Brandon-Valley/Artemis-Corner-DAQ-Board/Artemis Corner Board V2 FR.brd

## EAGLE design Artemis Corner Board V2 FR.brd (2016-04-18)

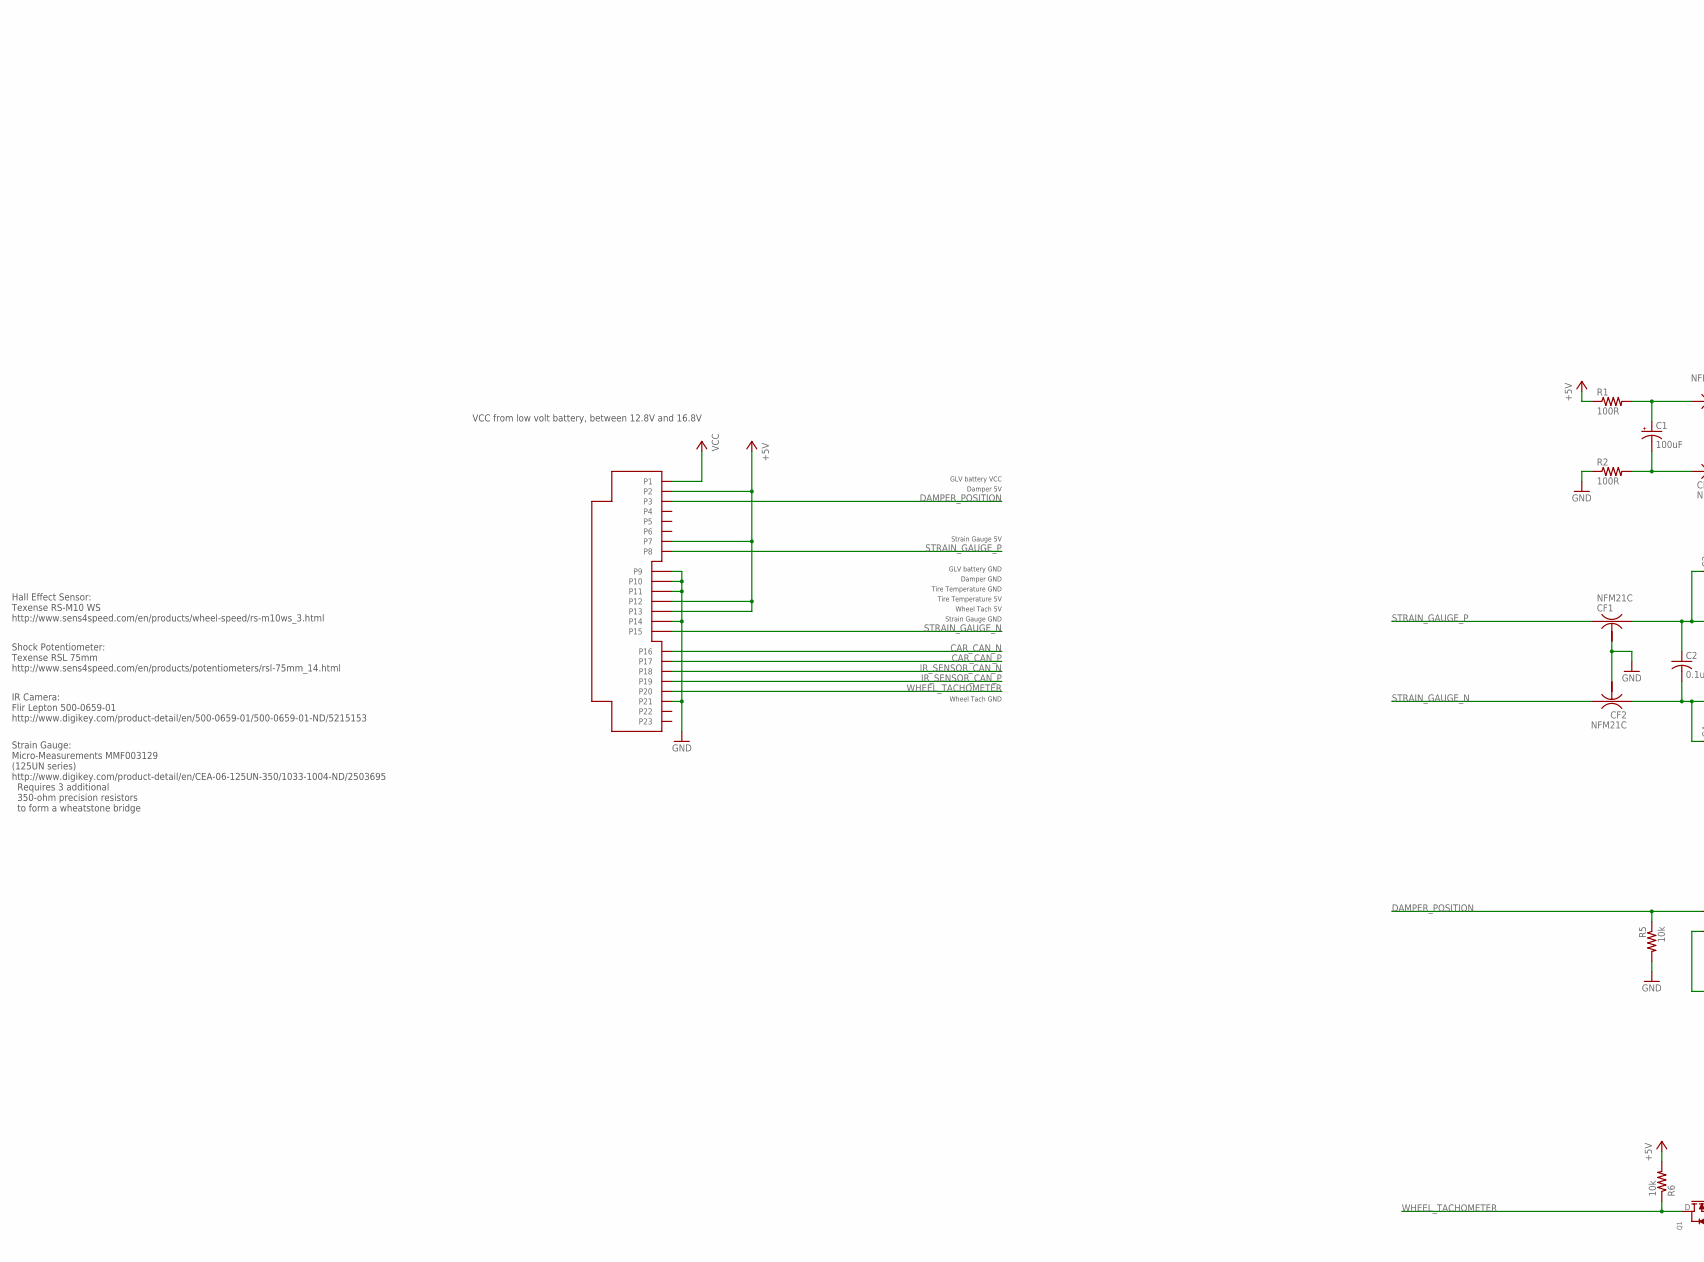
[picture p1: schematic Artemis Corner Board V2 FR.sch, part in row 1, column 1]

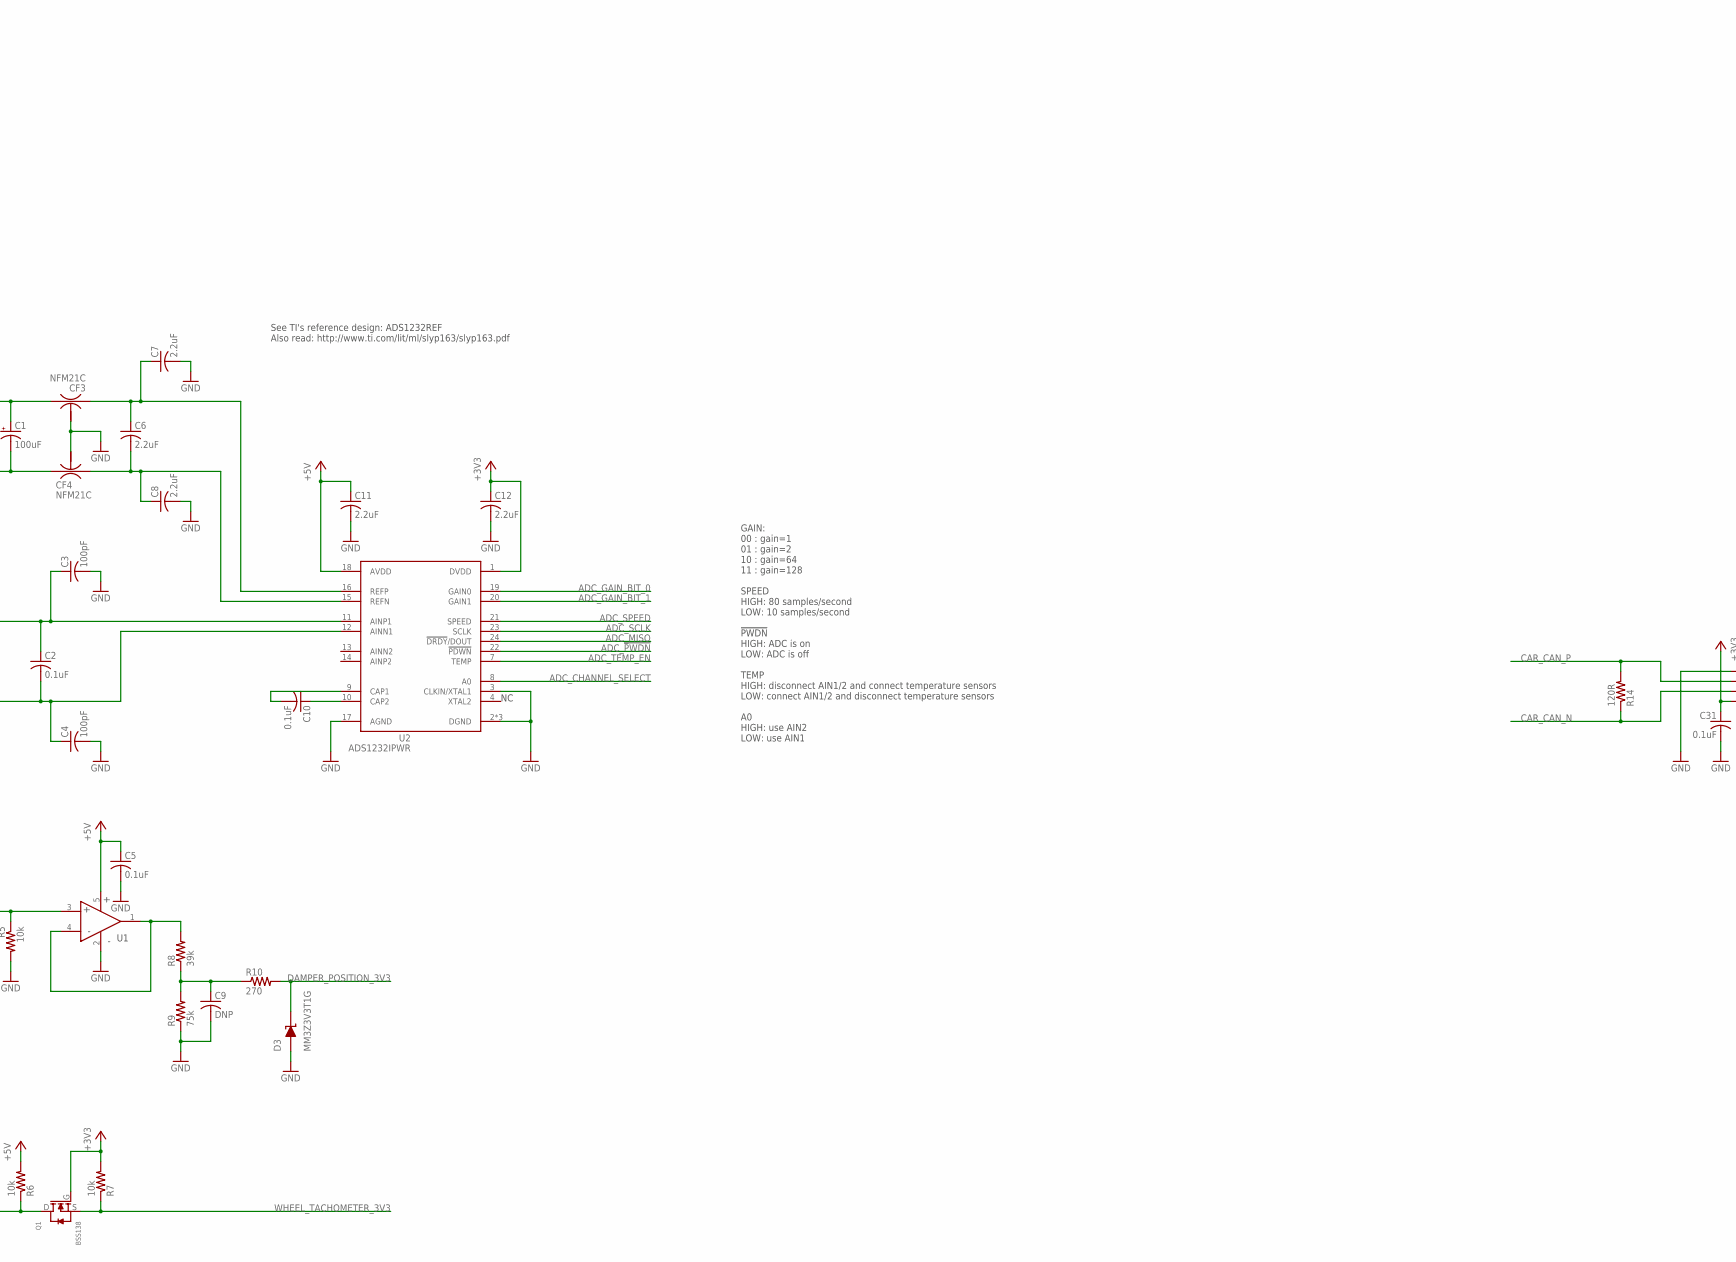
[picture p2: schematic Artemis Corner Board V2 FR.sch, part in row 1, column 2]

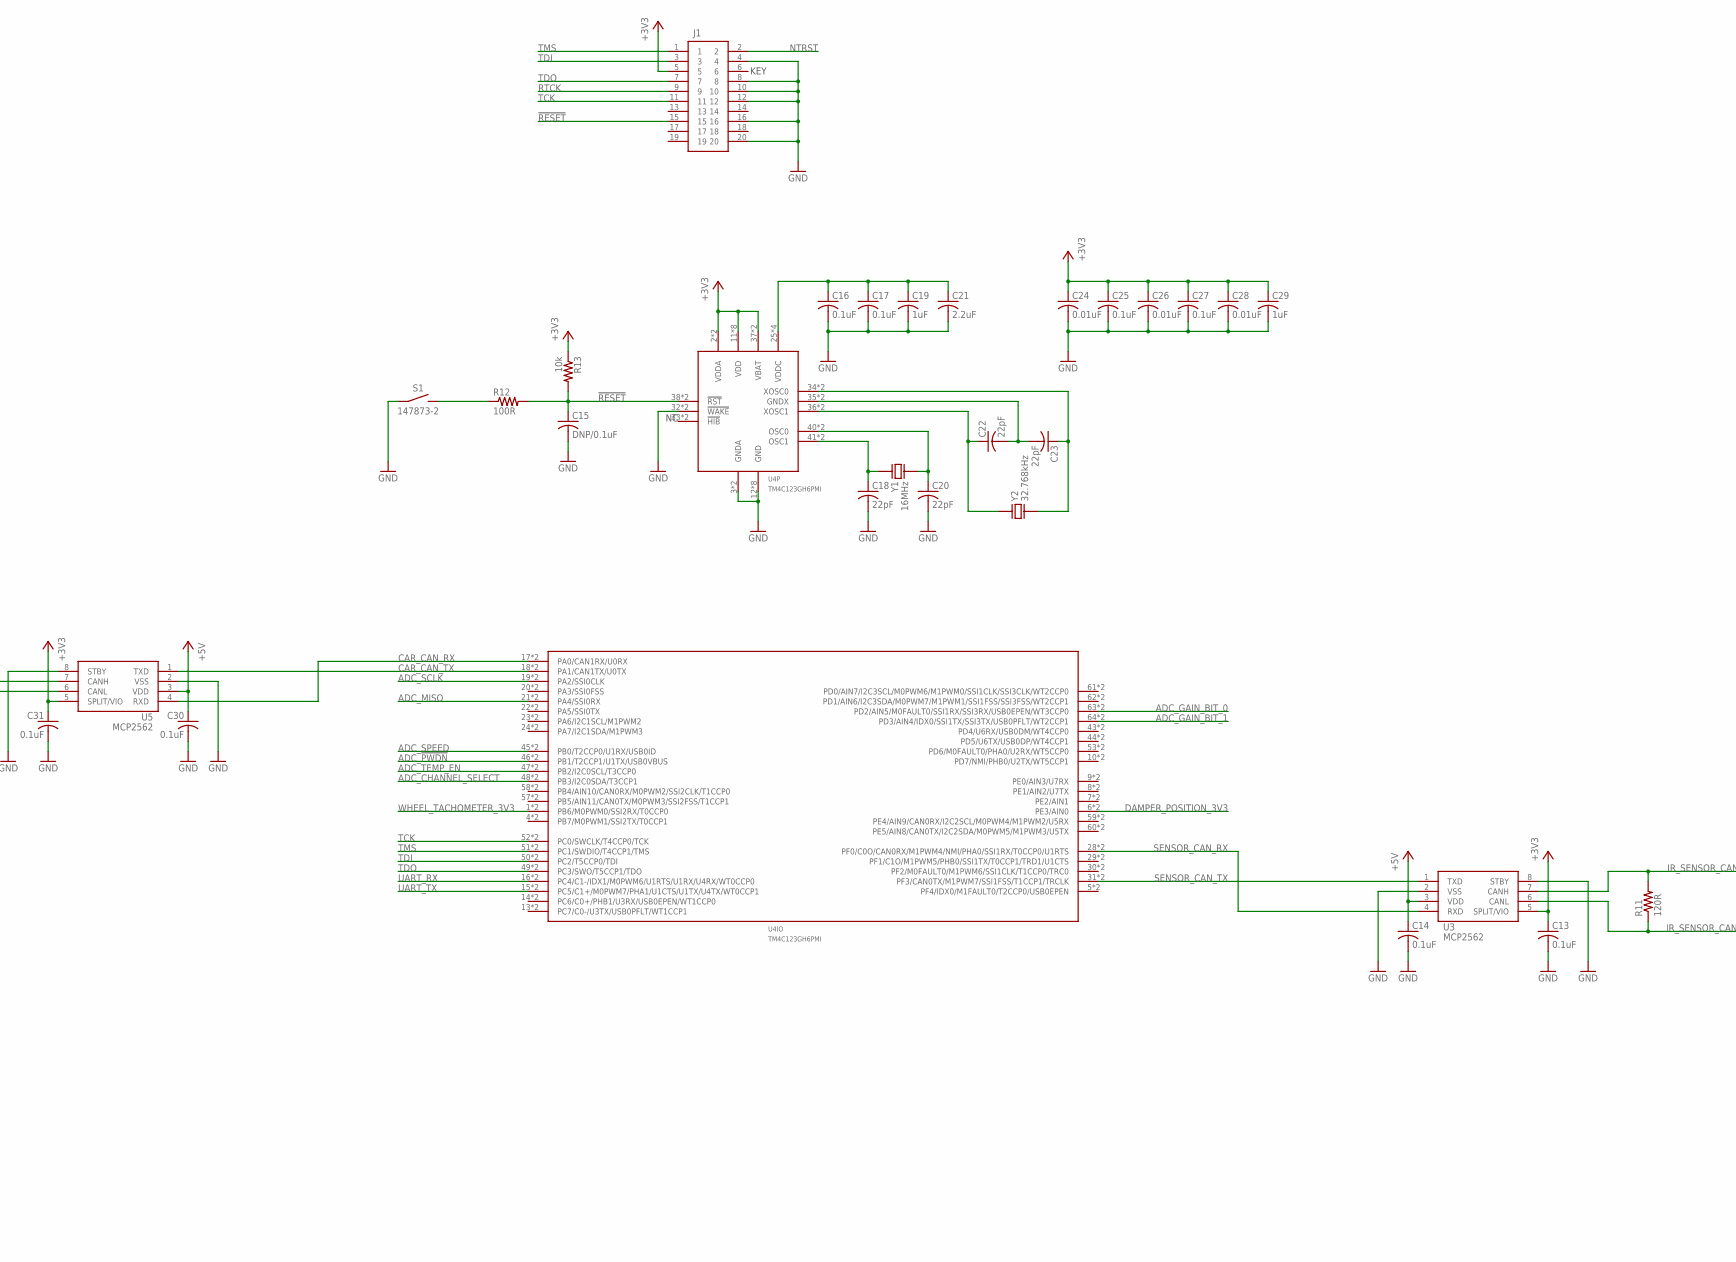
[picture p3: schematic Artemis Corner Board V2 FR.sch, part in row 1, column 3]

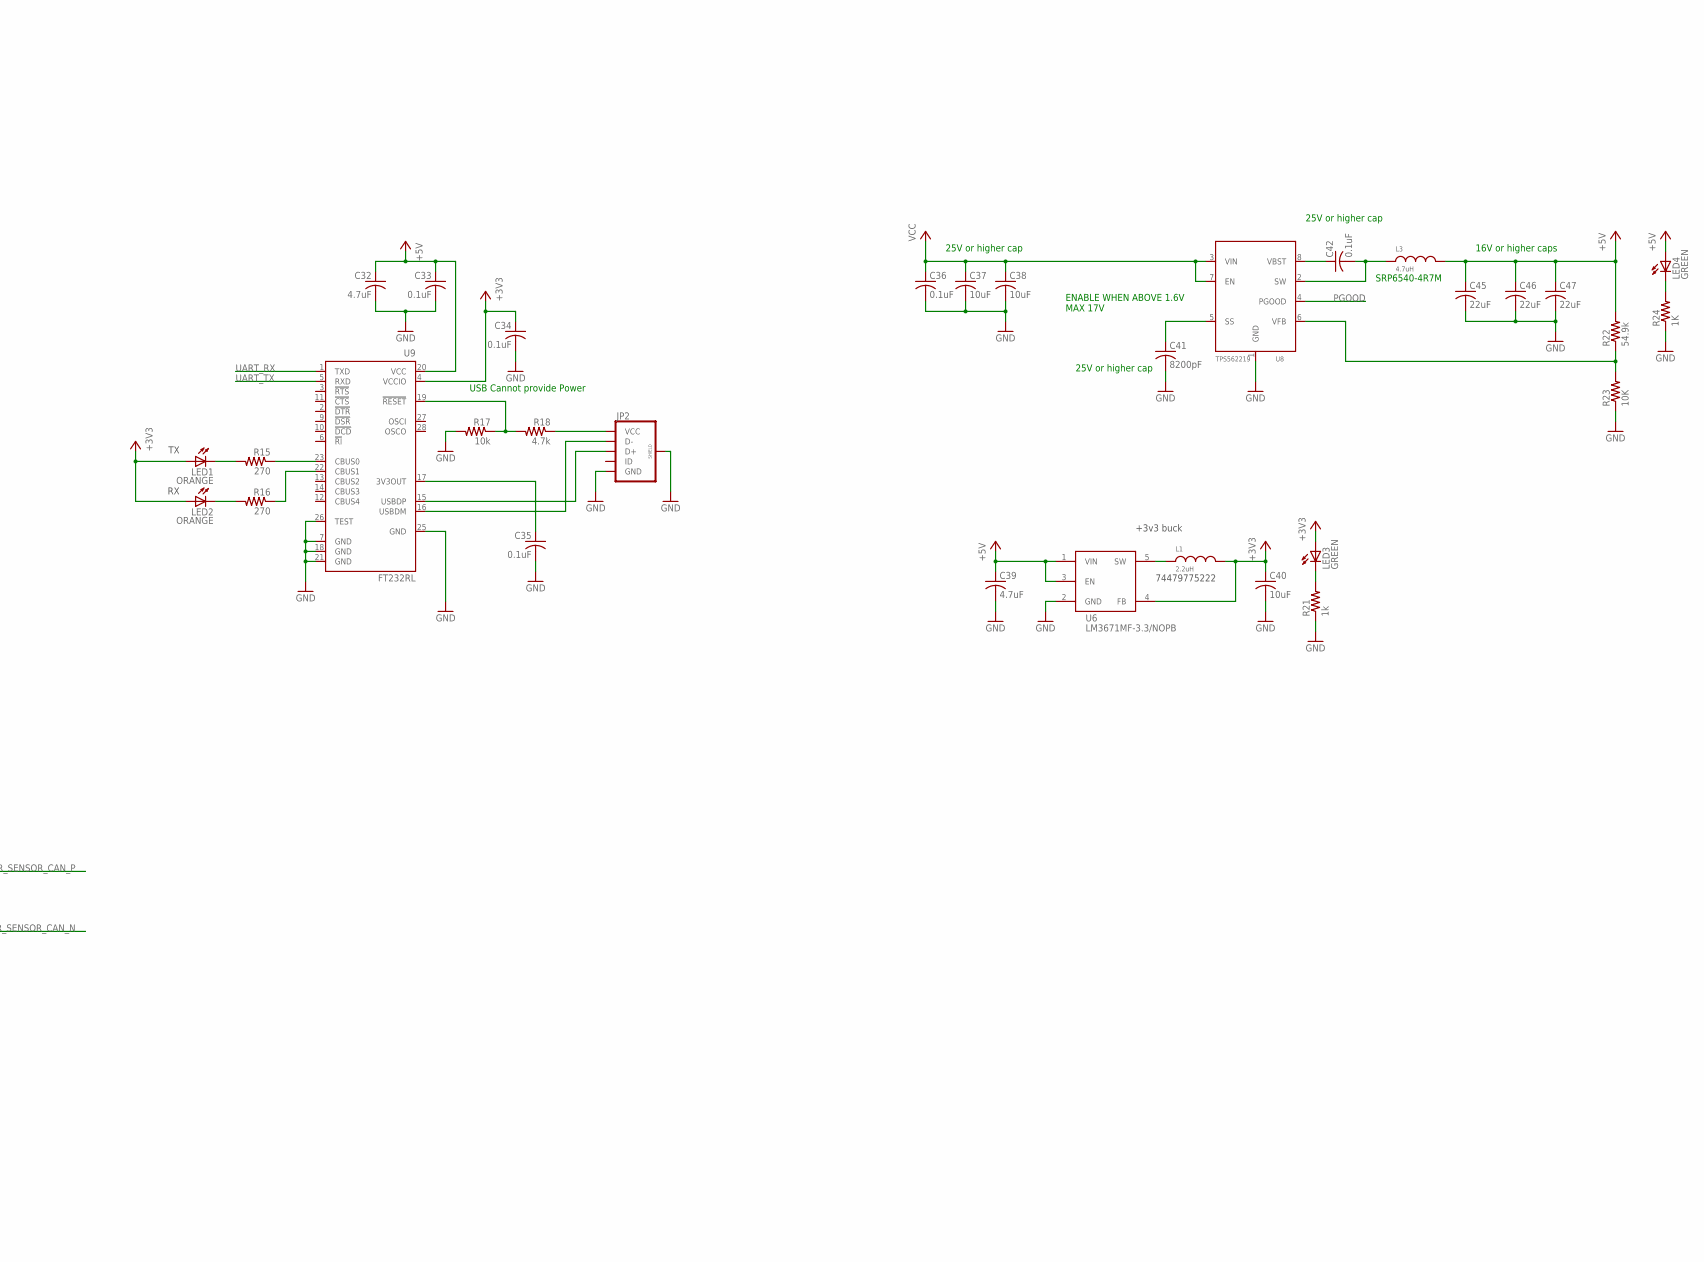
[picture p4: schematic Artemis Corner Board V2 FR.sch, part in row 1, column 4]

Parts:
C1: 100uF; D/7343-31W; PARTNO T494D107K010AT
C2, C10: 0.1uF; C0805; PARTNO *
C3, C4: 100pF; C0805; PARTNO *
C5, C13, C14, C16, C17, C25, C27, C30, C31, C33, C34, C35, C36, C42: 0.1uF; C0805; PARTNO GRM21BR71E104KA01L
C6, C7, C8, C11, C12, C21: 2.2uF; C0805; PARTNO *
C9: DNP; C0805; PARTNO *
C15: DNP/0.1uF; C0805; PARTNO *
C18, C20, C22, C23: 22pF; C0805; PARTNO C0805C220K5GACTU
C19, C29: 1uF; C0805; PARTNO *
C24, C26, C28: 0.01uF; C0805; PARTNO *
C32: 4.7uF; C0805; PARTNO GRM21BR71A475KA73K
C37, C38: 10uF; C0805; PARTNO GRM21BR61E106KA73L
C39: 4.7uF; C0805
C40: 10uF; C0805
C41: 8200pF; C0805; PARTNO C0805C822K5RACTU
C45, C46, C47: 22uF; C0805; PARTNO C2012JB1E226M125AC
CF1, CF2, CF3, CF4: NFM21C; PARTNO NFM21PC105B1C3D
D3: MM3Z3V3T1G; SOD-323; PARTNO MM3Z3V3T1G
H1: 776228-4
J1: CTI-20-MALE; SAMTEC-FTR-DUALROW; PARTNO M50-3601042
JP2: USB_MICROB_PLUG-PTH3; MOLEX-MICROUSB-B-105017-0001; PARTNO 1050170001
L1: 2.2uH; 0805; PARTNO 74479775222
L3: 4.7uH; SRP6540; PARTNO SRP6540-4R7M
LED1, LED2: ORANGE; CHIP-LED0805; PARTNO 598-8130-107F
LED3, LED4: GREEN; CHIP-LED0805; PARTNO 598-8170-107F
Q1: BSS138
R1, R2: 100R; R0805
R5, R6, R7, R17: 10k; R0805; PARTNO ERJ-6ENF1002V
R8: 39k; R0805; PARTNO ERJ-6ENF3902V
R9: 75k; R0805; PARTNO ERJ-6ENF7502V
R10, R15, R16: 270; R0805; PARTNO ERJ-6ENF2700V
R11, R14: 120R; R0805; PARTNO ERJ-6ENF1200V
R12: 100R; R0805; PARTNO *
R13: 10k; R0805; PARTNO *
R18: 4.7k; R0805; PARTNO ERJ-6ENF4701V
R21: 1k; R0805; PARTNO ERJ-6ENF1001V
R22: 54.9k; R0805; PARTNO ERA-6AEB5492V
R23: 10K; R0805; PARTNO ERJ-6ENF1002V
R24: 1K; R0805; PARTNO ERJ-6ENF1001V
S1: 147873-2; TE-147873-2; PARTNO 147873-2
U1: OPA365AIDBVR; SOT23-5
U2: ADS1232IPWR; ADS1232IPW
U3, U5: MCP2562; SOIC8-N_MC; PARTNO MCP2562FD-E/SN
U4: TM4C123GH6PMI; PQFP-64
U6: LM3671MF-3.3/NOPB; SOT23-5
U8: TPS562219; PARTNO *
U9: FT232RL; SSOP28; PARTNO FT232RL-REEL
Y1: 16MHz; CSM-3X; PARTNO ECS-160-20-3X-TR
Y2: 32.768kHz; AB26TRQ; PARTNO AB26TRQ-32.768KHZ-T

Connections:
!RESET!: C15.1, J1.15, R12.2, R13.2, U4.38 (!RST!), U4.MASK-38 (!RST!)
+3V3: C12.1, C13.1, C24.1, C25.1, C26.1, C27.1, C28.1, C29.1, C31.1, C34.1, C40.1, J1.5, L1.2, LED1.A, LED2.A, LED3.A, Q1.G, R7.2, R13.1, U2.1 (DVDD), U3.5 (SPLIT/VIO), U4.2 (VDDA), U4.11 (VDD), U4.26 (VDD), U4.37 (VBAT), U4.42 (VDD), U4.54 (VDD), U4.MASK-2 (VDDA), U4.MASK-11 (VDD), U4.MASK-26 (VDD), U4.MASK-37 (VBAT), U4.MASK-42 (VDD), U4.MASK-54 (VDD), U5.5 (SPLIT/VIO), U6.4 (FB), U9.4 (VCCIO)
+5V: C5.1, C11.1, C14.1, C30.1, C32.1, C33.1, C39.1, C45.1, C46.1, C47.1, H1.P$2 (P2), H1.P$7 (P7), H1.P$12 (P12), H1.P$13 (P13), L3.P$2, LED4.A, R1.1, R6.2, R22.2, U1.5 (V+), U2.18 (AVDD), U3.3 (VDD), U5.3 (VDD), U6.1 (VIN), U6.3 (EN), U9.20 (VCC)
ADC_!PWDN!: U2.22 (!PDWN!), U4.46 (PB1/T2CCP1/U1TX/USB0VBUS), U4.MASK-46 (PB1/T2CCP1/U1TX/USB0VBUS)
ADC_CHANNEL_SELECT: U2.8 (A0), U4.48 (PB3/I2C0SDA/T3CCP1), U4.MASK-48 (PB3/I2C0SDA/T3CCP1)
ADC_GAIN_BIT_0: U2.19 (GAIN0), U4.63 (PD2/AIN5/M0FAULT0/SSI1RX/SSI3RX/USB0EPE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), U4.MASK-63 (PD2/AIN5/M0FAULT0/SSI1RX/SSI3RX/USB0EPE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)
ADC_GAIN_BIT_1: U2.20 (GAIN1), U4.64 (PD3/AIN4/IDX0/SSI1TX/SSI3TX/USB0PFLT/WT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), U4.MASK-64 (PD3/AIN4/IDX0/SSI1TX/SSI3TX/USB0PFLT/WT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)
ADC_MISO: U2.24 (!DRDY!/DOUT), U4.21 (PA4/SSI0RX), U4.MASK-21 (PA4/SSI0RX)
ADC_SCLK: U2.23 (SCLK), U4.19 (PA2/SSI0CLK), U4.MASK-19 (PA2/SSI0CLK)
ADC_SPEED: U2.21 (SPEED), U4.45 (PB0/T2CCP0/U1RX/USB0ID), U4.MASK-45 (PB0/T2CCP0/U1RX/USB0ID)
ADC_TEMP_EN: U2.7 (TEMP), U4.47 (PB2/I2C0SCL/T3CCP0), U4.MASK-47 (PB2/I2C0SCL/T3CCP0)
CAR_CAN_N: H1.P$16 (P16), R14.1, U5.6 (CANL)
CAR_CAN_P: H1.P$17 (P17), R14.2, U5.7 (CANH)
CAR_CAN_RX: U4.17 (PA0/CAN1RX/U0RX), U4.MASK-17 (PA0/CAN1RX/U0RX), U5.4 (RXD)
CAR_CAN_TX: U4.18 (PA1/CAN1TX/U0TX), U4.MASK-18 (PA1/CAN1TX/U0TX), U5.1 (TXD)
DAMPER_POSITION: H1.P$3 (P3), R5.1, U1.3 (NONINVERTING)
DAMPER_POSITION_3V3: D3.CATHODE, R10.2, U4.6 (PE3/AIN0), U4.MASK-6 (PE3/AIN0)
GND: C3.2, C4.2, C5.2, C7.2, C8.2, C9.2, C11.2, C12.2, C13.2, C14.2, C15.2, C16.2, C17.2, C18.2, C19.2, C20.2, C21.2, C24.2, C25.2, C26.2, C27.2, C28.2, C29.2, C30.2, C31.2, C32.2, C33.2, C34.2, C35.2, C36.2, C37.2, C38.2, C39.2, C40.2, C41.2, C45.2, C46.2, C47.2, CF1.2@1 (2), CF2.2@1 (2), CF3.2@1 (2), CF4.2@1 (2), D3.ANODE, H1.P$9 (P9), H1.P$10 (P10), H1.P$11 (P11), H1.P$14 (P14), H1.P$21 (P21), J1.4, J1.8, J1.10, J1.12, J1.16, J1.20, JP2.5 (GND), JP2.P$5 (GND), JP2.P$6 (SHIELD), JP2.P$7 (SHIELD), JP2.P$8 (SHIELD), JP2.P$9 (SHIELD), R2.1, R5.2, R9.1, R17.2, R21.1, R23.1, R24.1, S1.P$1 (1), U1.2 (V-), U2.2 (DGND), U2.3 (CLKIN/XTAL1), U2.5 (DGND), U2.6 (DGND), U2.17 (AGND), U3.2 (VSS), U3.8 (STBY), U4.3 (GNDA), U4.12 (GND), U4.27 (GND), U4.32 (!WAKE!), U4.39 (GND), U4.55 (GND), U4.MASK-3 (GNDA), U4.MASK-12 (GND), U4.MASK-27 (GND), U4.MASK-32 (!WAKE!), U4.MASK-39 (GND), U4.MASK-55 (GND), U5.2 (VSS), U5.8 (STBY), U6.2 (GND), U8.1 (GND), U9.7 (GND), U9.18 (GND), U9.21 (GND), U9.25 (GND), U9.26 (TEST)
IR_SENSOR_CAN_N: H1.P$18 (P18), R11.1, U3.6 (CANL)
IR_SENSOR_CAN_P: H1.P$19 (P19), R11.2, U3.7 (CANH)
unnamed: C18.1, U4.41 (OSC1), U4.MASK-41 (OSC1), Y1.P$1
unnamed: LED3.C, R21.2
unnamed: LED4.C, R24.2
unnamed: C20.1, U4.40 (OSC0), U4.MASK-40 (OSC0), Y1.P$2
unnamed: C10.1, U2.10 (CAP2)
unnamed: R12.1, S1.P$2 (2)
unnamed: C10.2, U2.9 (CAP1)
unnamed: C6.1, C7.1, CF3.1, U2.16 (REFP)
unnamed: L1.1, U6.5 (SW)
unnamed: C6.2, C8.1, CF4.3, U2.15 (REFN)
unnamed: C1.+, CF3.3, R1.2
unnamed: R8.2, U1.1 (OUT), U1.4 (INVERTING)
unnamed: C22.1, U4.36 (XOSC1), U4.MASK-36 (XOSC1), Y2.1
unnamed: C9.1, R8.1, R9.2, R10.1
unnamed: C23.1, U4.34 (XOSC0), U4.MASK-34 (XOSC0), Y2.2
unnamed: C1.-, CF4.1, R2.2
unnamed: C35.1, U9.17 (3V3OUT)
unnamed: JP2.1 (VCC), JP2.P$1 (VCC), R18.1
unnamed: C22.2, C23.2, U4.35 (GNDX), U4.MASK-35 (GNDX)
unnamed: C2.1, C3.1, CF1.3, U2.11 (AINP1)
unnamed: C2.2, C4.1, CF2.1, U2.12 (AINN1)
unnamed: R16.1, U9.22 (CBUS1)
unnamed: R15.1, U9.23 (CBUS0)
unnamed: LED1.C, R15.2
unnamed: LED2.C, R16.2
unnamed: R17.1, R18.2, U9.19 (!RESET)
NTRST: J1.2
PGOOD: U8.4 (PGOOD)
RTCK: J1.9
SENSOR_CAN_RX: U3.4 (RXD), U4.28 (PF0/C0O/CAN0RX/M1PWM4/NMI/PHA0/SSI1RX/T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), U4.MASK-28 (PF0/C0O/CAN0RX/M1PWM4/NMI/PHA0/SSI1RX/T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)
SENSOR_CAN_TX: U3.1 (TXD), U4.31 (PF3/CAN0TX/M1PWM7/SSI1FSS/T1CCP1/TRCLK), U4.MASK-31 (PF3/CAN0TX/M1PWM7/SSI1FSS/T1CCP1/TRCLK)
SS_5V: C41.1, U8.5 (SS)
STRAIN_GAUGE_N: CF2.3, H1.P$15 (P15)
STRAIN_GAUGE_P: CF1.1, H1.P$8 (P8)
SW_5V: C42.2, L3.P$1, U8.2 (SW)
TCK: J1.11, U4.52 (PC0/SWCLK/T4CCP0/TCK), U4.MASK-52 (PC0/SWCLK/T4CCP0/TCK)
TDI: J1.3, U4.50 (PC2/T5CCP0/TDI), U4.MASK-50 (PC2/T5CCP0/TDI)
TDO: J1.7, U4.49 (PC3/SWO/T5CCP1/TDO), U4.MASK-49 (PC3/SWO/T5CCP1/TDO)
TMS: J1.1, U4.51 (PC1/SWDIO/T4CCP1/TMS), U4.MASK-51 (PC1/SWDIO/T4CCP1/TMS)
UART_RX: U4.16 (PC4/C1-/IDX1/M0PWM6/U1RTS/U1RX/U4RX/WT0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), U4.MASK-16 (PC4/C1-/IDX1/M0PWM6/U1RTS/U1RX/U4RX/WT0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), U9.1 (TXD)
UART_TX: U4.15 (PC5/C1+/M0PWM7/PHA1/U1CTS/U1TX/U4TX/WT0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), U4.MASK-15 (PC5/C1+/M0PWM7/PHA1/U1CTS/U1TX/U4TX/WT0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), U9.5 (RXD)
USB_D_N: JP2.2 (D-), JP2.P$2 (D-), U9.16 (USBDM)
USB_D_P: JP2.3 (D+), JP2.P$3 (D+), U9.15 (USBDP)
VBST_5V: C42.1, U8.8 (VBST)
VCC: C36.1, C37.1, C38.1, H1.P$1 (P1), U8.3 (VIN), U8.7 (EN)
VDDC: C16.1, C17.1, C19.1, C21.1, U4.25 (VDDC), U4.56 (VDDC), U4.MASK-25 (VDDC), U4.MASK-56 (VDDC)
VFB_5V: R22.1, R23.2, U8.6 (VFB)
WHEEL_TACHOMETER: H1.P$20 (P20), Q1.D, R6.1
WHEEL_TACHOMETER_3V3: Q1.S, R7.1, U4.1 (PB6/M0PWM0/SSI2RX/T0CCP0), U4.MASK-1 (PB6/M0PWM0/SSI2RX/T0CCP0)

Notes on the sheet:
VCC from low volt battery, between 12.8V and 16.8V
+3v3 buck
USB Cannot provide Power
KEY
SRP6540-4R7M
ENABLE WHEN ABOVE 1.6V MAX 17V
25V or higher cap
16V or higher caps
Strain Gauge GND
Damper GND
Wheel Tach GND
Tire Temperature GND
Tire Temperature 5V
Wheel Tach 5V
Damper 5V
Strain Gauge 5V
See TI's reference design: ADS1232REF Also read: http://www.ti.com/lit/ml/slyp163/slyp163.pdf
GAIN: 00 : gain=1 01 : gain=2 10 : gain=64 11 : gain=128 SPEED HIGH: 80 samples/second LOW: 10 samples/second !PWDN! HIGH: ADC is on LOW: ADC is off TEMP HIGH: disconnect AIN1/2 and connect temperature sensors LOW: connect AIN1/2 and disconnect temperature sensors A0 HIGH: use AIN2 LOW: use AIN1
Hall Effect Sensor: Texense RS-M10 WS http://www.sens4speed.com/en/products/wheel-speed/rs-m10ws_3.html
Shock Potentiometer: Texense RSL 75mm http://www.sens4speed.com/en/products/potentiometers/rsl-75mm_14.html
IR Camera: Flir Lepton 500-0659-01 http://www.digikey.com/product-detail/en/500-0659-01/500-0659-01-ND/5215153
Strain Gauge: Micro-Measurements MMF003129 (125UN series) http://www.digikey.com/product-detail/en/CEA-06-125UN-350/1033-1004-ND/2503695 Requires 3 additional 350-ohm precision resistors to form a wheatstone bridge
GLV battery VCC
GLV battery GND
74479775222

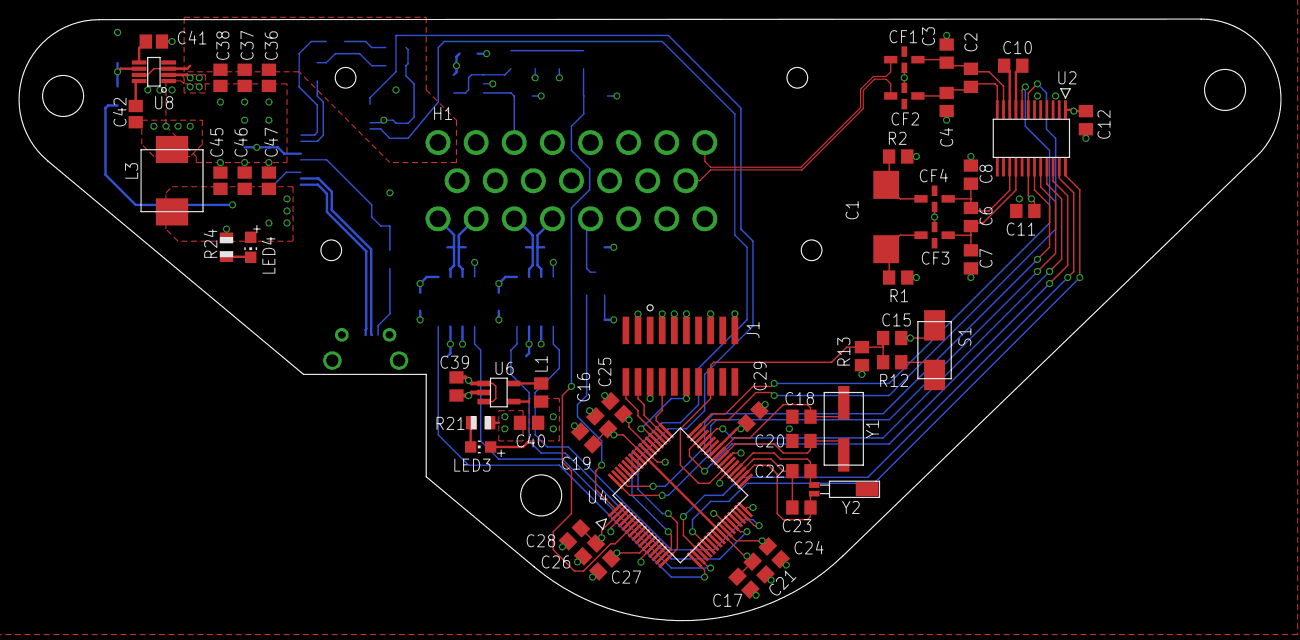
[picture p5: board Artemis Corner Board V2 FR.brd from above]

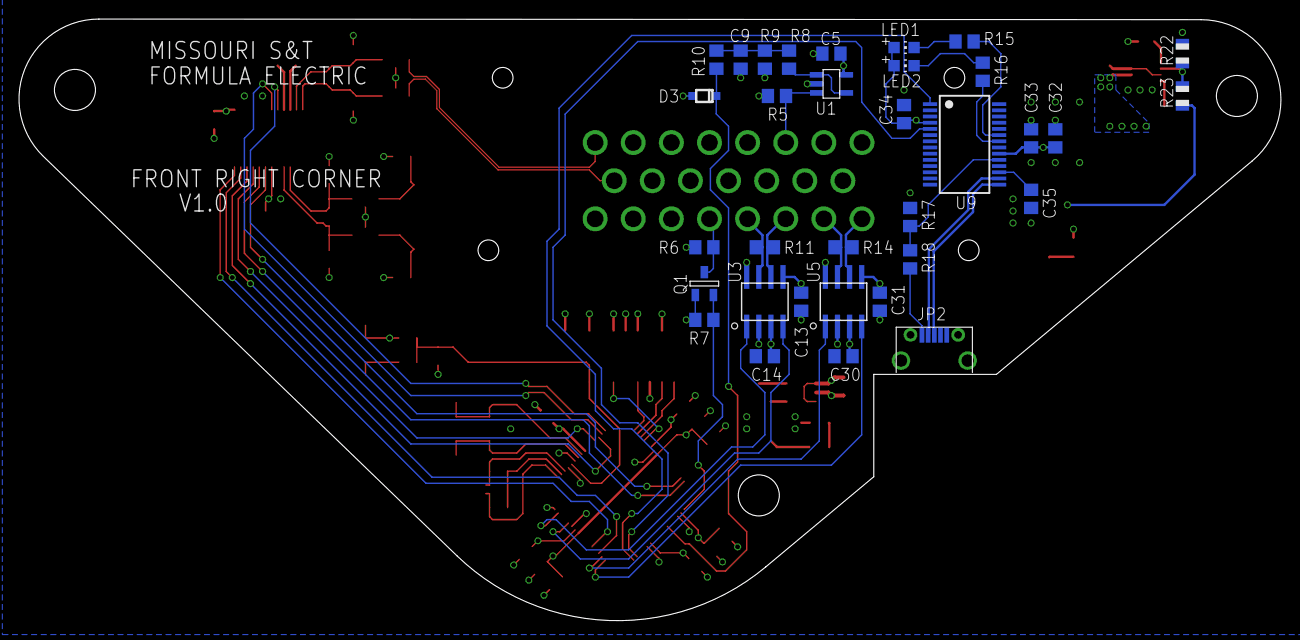
[picture p6: board Artemis Corner Board V2 FR.brd from below]

Board: 4 copper layers, 132.4 x 63.1 mm, 91 parts (33 on the bottom side), 66 nets.
