Brandon-Valley/Artemis-Corner-DAQ-Board/(commit log)

2016-01-14 First Commit: At this point same as FL Corner Board
    [Artemis Corner Board V2 FR.brd, Artemis Corner Board V2 FR.sch]
2016-01-14 Finally got shape right
    [Artemis Corner Board V2 FR.brd, Artemis Corner Board V2 FR.sch]
2016-01-15 All regulators done, pin out for sealed connector almost done, need outs for image sensor
    [Artemis Corner Board V2 FR.brd, Artemis Corner Board V2 FR.sch]
2016-01-16 About to delete 1V2 and 2V8 Regulators because switching Image sensor
    [Artemis Corner Board V2 FR.brd, Artemis Corner Board V2 FR.sch]
2016-01-17 Everything done exept for scary LEDs
    [Artemis Corner Board V2 FR.brd, Artemis Corner Board V2 FR.sch]
2016-01-19 Done (1st)
    [Artemis Corner Board V2 FR.brd, Artemis Corner Board V2 FR.sch]
2016-01-20 Down to only 4 LEDs
    [Artemis Corner Board V2 FR.brd, Artemis Corner Board V2 FR.sch]
2016-01-26 Added decoupling CAPS and Button for reset
    [Artemis Corner Board V2 FR.brd, Artemis Corner Board V2 FR.sch]
2016-01-28 About to go from IR sensors to Image sensor
    [Artemis Corner Board V2 FR.sch]
2016-01-30 Added Series Termination Resistors
    [Artemis Corner Board V2 FR.brd, Artemis Corner Board V2 FR.sch]
2016-02-06 fixed board errors and added ESD Protection
    [Artemis Corner Board V2 FR.brd, Artemis Corner Board V2 FR.sch]
2016-02-24 Made list fixes
    [Artemis Corner Board V2 FR.brd, Artemis Corner Board V2 FR.sch]
2016-03-15 Updated a lot of stuff
    [Artemis Corner Board V2 FR.brd, Artemis Corner Board V2 FR.sch]
2016-04-01 Changed to Tiva C with two CAN modules; modified sensor input scaling
    [Artemis Corner Board V2 FR.brd, Artemis Corner Board V2 FR.sch]
2016-04-01 Grouped components in layout
    [Artemis Corner Board V2 FR.brd, Artemis Corner Board V2 FR.sch]
2016-04-01 Changed to smaller LM3671 regulators
    [Artemis Corner Board V2 FR.brd, Artemis Corner Board V2 FR.sch]
2016-04-01 Playing with layout arrangement
    [Artemis Corner Board V2 FR.brd, Artemis Corner Board V2 FR.sch]
2016-04-01 Switched to 23-pin ampseal connector
    [Artemis Corner Board V2 FR.brd, Artemis Corner Board V2 FR.sch]
2016-04-02 Routed everything except the usb components, which may get removed.
    [Artemis Corner Board V2 FR.brd, Artemis Corner Board V2 FR.sch]
2016-04-02 Crammed the usb circuitry onto the board
    [Artemis Corner Board V2 FR.brd]
2016-04-02 Fixed dimension layer around usb port
    [Artemis Corner Board V2 FR.brd]
2016-04-02 Moved reference designators
    [Artemis Corner Board V2 FR.brd]
2016-04-02 Placed board labels/logo
    [Artemis Corner Board V2 FR.brd]
2016-04-02 ERC/DRC fixes. This still needs to be mechanically reviewed
    [Artemis Corner Board V2 FR.brd, Artemis Corner Board V2 FR.sch]
2016-04-18 Fixed layout of 5v regulator
    [Artemis Corner Board V2 FR.brd]
2016-09-21 Added a few notes, about to start on new Corner DAQ Board
    [Artemis Corner Board V2 FR.sch]
